M-Gargantua/FSAE-Dash-Warning-Panel/Dash_Warning_Panel.kicad_pcb

## KiCad design Dash_Warning_Panel.kicad_pcb (2019-04-27)

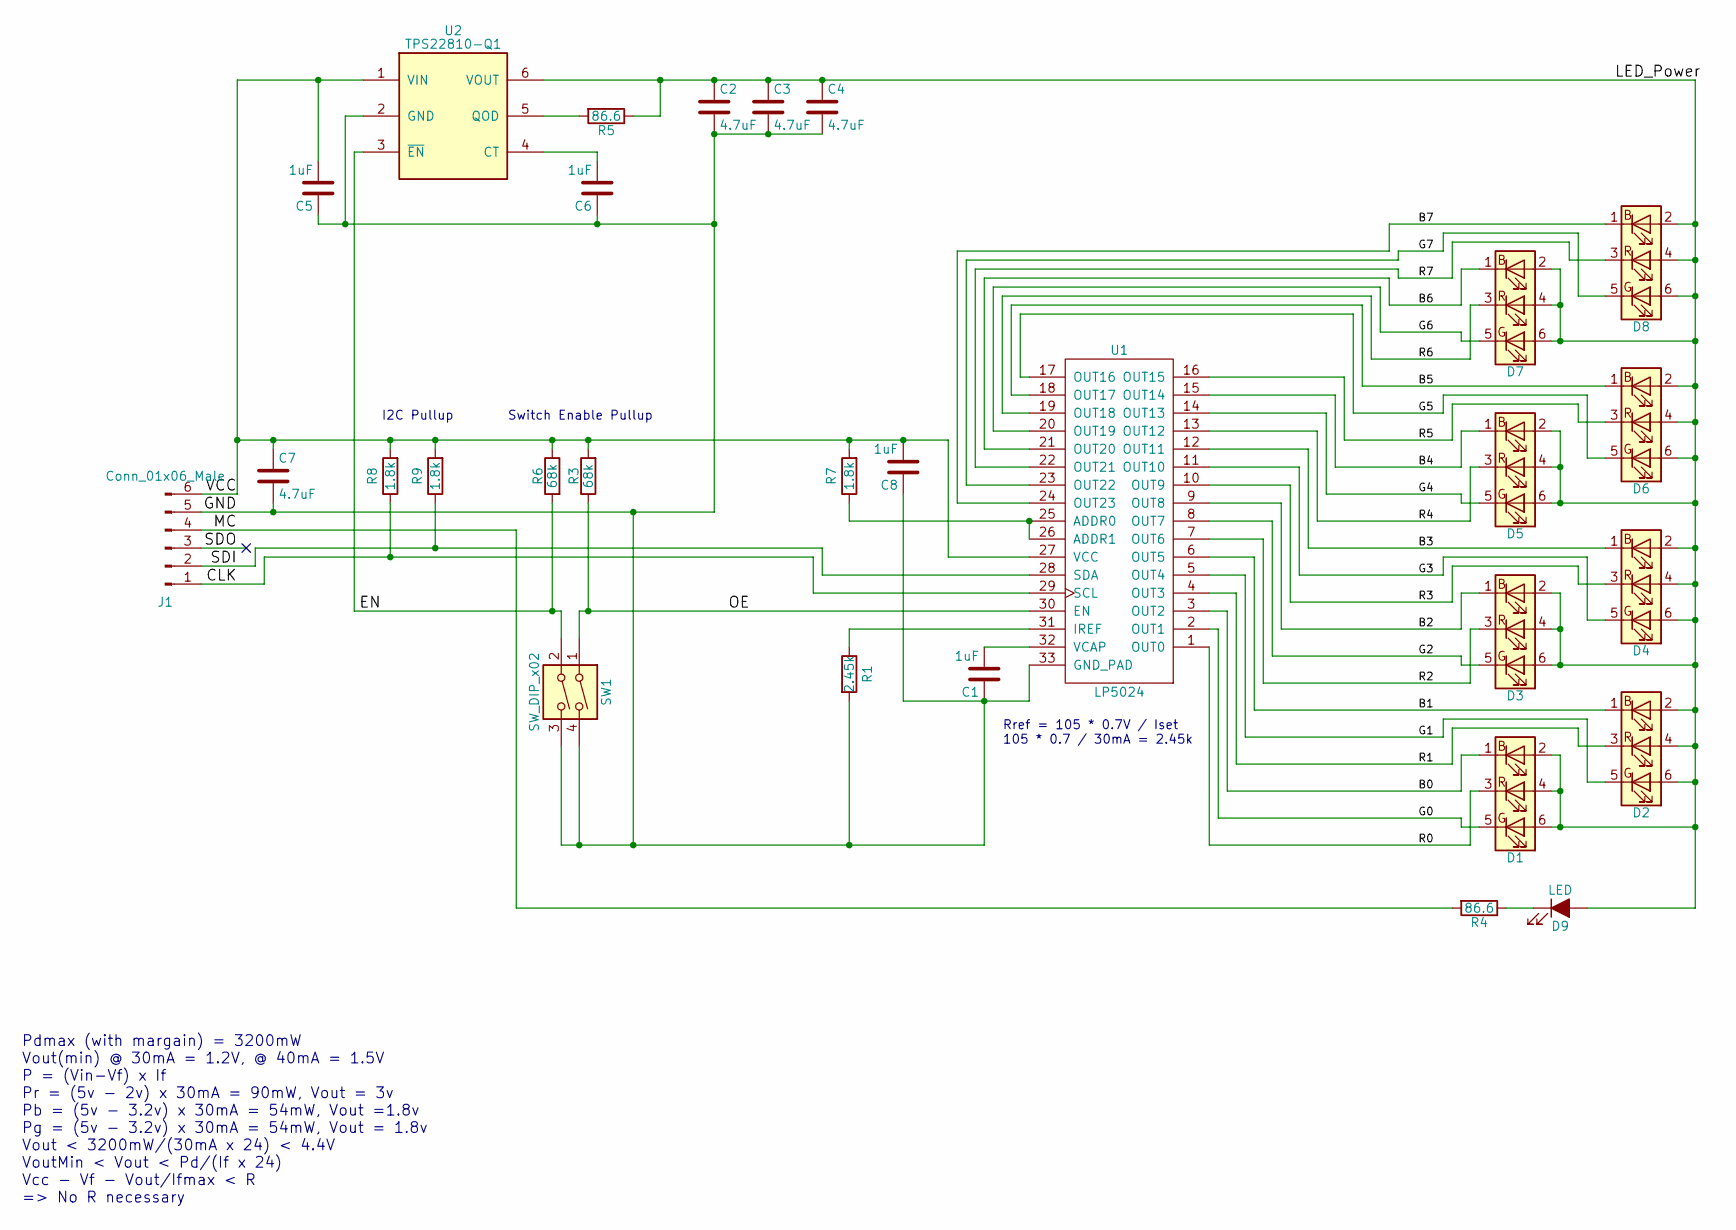
[picture p1: schematic Dash_Warning_Panel.sch]

Parts:
C1, C5, C6, C8: 1uF; C_0805
C2, C3, C4, C7: 4.7uF; C_1206
D1, D2, D3, D4, D5, D6, D7, D8: LED_RGB_Wurth; LED_RGB_3528
D9: LED; LED_0805
J1: Conn_01x06_Male; TE_84953-6_1x06_P1.0mm_Horizontal
R1: 2.45k; R_1206
R3, R6: 68k; R_1206
R4, R5: 86.6; R_0805
R7, R8, R9: 1.8k; R_0805
SW1: SW_DIP_x02; 2.54mm_DIP_Switch_2_Position
U1: LP5024; QFN-32-1EP_5x5mm_Pitch0.5mm
U2: TPS22810-Q1; SOT-23-6

Connections:
/B0: D1.1 (BK), U1.3 (OUT2)
/B1: D2.1 (BK), U1.6 (OUT5)
/B2: D3.1 (BK), U1.9 (OUT8)
/B3: D4.1 (BK), U1.12 (OUT11)
/B4: D5.1 (BK), U1.15 (OUT14)
/B5: D6.1 (BK), U1.18 (OUT17)
/B6: D7.1 (BK), U1.21 (OUT20)
/B7: D8.1 (BK), U1.24 (OUT23)
/CLK: J1.1, R8.1, U1.29 (SCL)
/EN: R6.2, SW1.2, U2.3 (~EN)
/G0: D1.5 (RK), U1.2 (OUT1)
/G1: D2.5 (RK), U1.5 (OUT4)
/G2: D3.5 (RK), U1.8 (OUT7)
/G3: D4.5 (RK), U1.11 (OUT10)
/G4: D5.5 (RK), U1.14 (OUT13)
/G5: D6.5 (RK), U1.17 (OUT16)
/G6: D7.5 (RK), U1.20 (OUT19)
/G7: D8.5 (RK), U1.23 (OUT22)
/GND: C1.1, C2.2, C3.2, C4.2, C5.1, C6.1, C7.2, C8.1, J1.5, R1.2, SW1.3, SW1.4, U1.33 (GND_PAD), U2.2 (GND)
/LED_Power: C2.1, C3.1, C4.1, D1.2 (BA), D1.4 (GA), D1.6 (RA), D2.2 (BA), D2.4 (GA), D2.6 (RA), D3.2 (BA), D3.4 (GA), D3.6 (RA), D4.2 (BA), D4.4 (GA), D4.6 (RA), D5.2 (BA), D5.4 (GA), D5.6 (RA), D6.2 (BA), D6.4 (GA), D6.6 (RA), D7.2 (BA), D7.4 (GA), D7.6 (RA), D8.2 (BA), D8.4 (GA), D8.6 (RA), D9.2 (A), R5.1, U2.6 (VOUT)
/MC: J1.4, R4.2
/OE: R3.1, SW1.1, U1.30 (EN)
/R0: D1.3 (GK), U1.1 (OUT0)
/R1: D2.3 (GK), U1.4 (OUT3)
/R2: D3.3 (GK), U1.7 (OUT6)
/R3: D4.3 (GK), U1.10 (OUT9)
/R4: D5.3 (GK), U1.13 (OUT12)
/R5: D6.3 (GK), U1.16 (OUT15)
/R6: D7.3 (GK), U1.19 (OUT18)
/R7: D8.3 (GK), U1.22 (OUT21)
/SDI: J1.2, R9.1, U1.28 (SDA)
/SDO: J1.3
/VCC: C5.2, C7.1, C8.2, J1.6, R3.2, R6.1, R7.2, R8.2, R9.2, U1.27 (VCC), U2.1 (VIN)
unnamed: C1.2, U1.32 (VCAP)
unnamed: C6.2, U2.4 (CT)
unnamed: D9.1 (K), R4.1
unnamed: R1.1, U1.31 (IREF)
unnamed: R5.2, U2.5 (QOD)
unnamed: R7.1, U1.25 (ADDR0), U1.26 (ADDR1)

Notes on the sheet:
Pdmax (with margain) = 3200mW Vout(min) @ 30mA = 1.2V, @ 40mA = 1.5V P = (Vin-Vf) x If Pr = (5v - 2v) x 30mA = 90mW, Vout = 3v Pb = (5v - 3.2v) x 30mA = 54mW, Vout =1.8v Pg = (5v - 3.2v) x 30mA = 54mW, Vout = 1.8v Vout < 3200mW/(30mA x 24) < 4.4V VoutMin < Vout < Pd/(If x 24) Vcc - Vf - Vout/Ifmax 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
Rref = 105 * 0.7V / Iset 105 * 0.7 / 30mA = 2.45k
I2C Pullup
Switch Enable Pullup

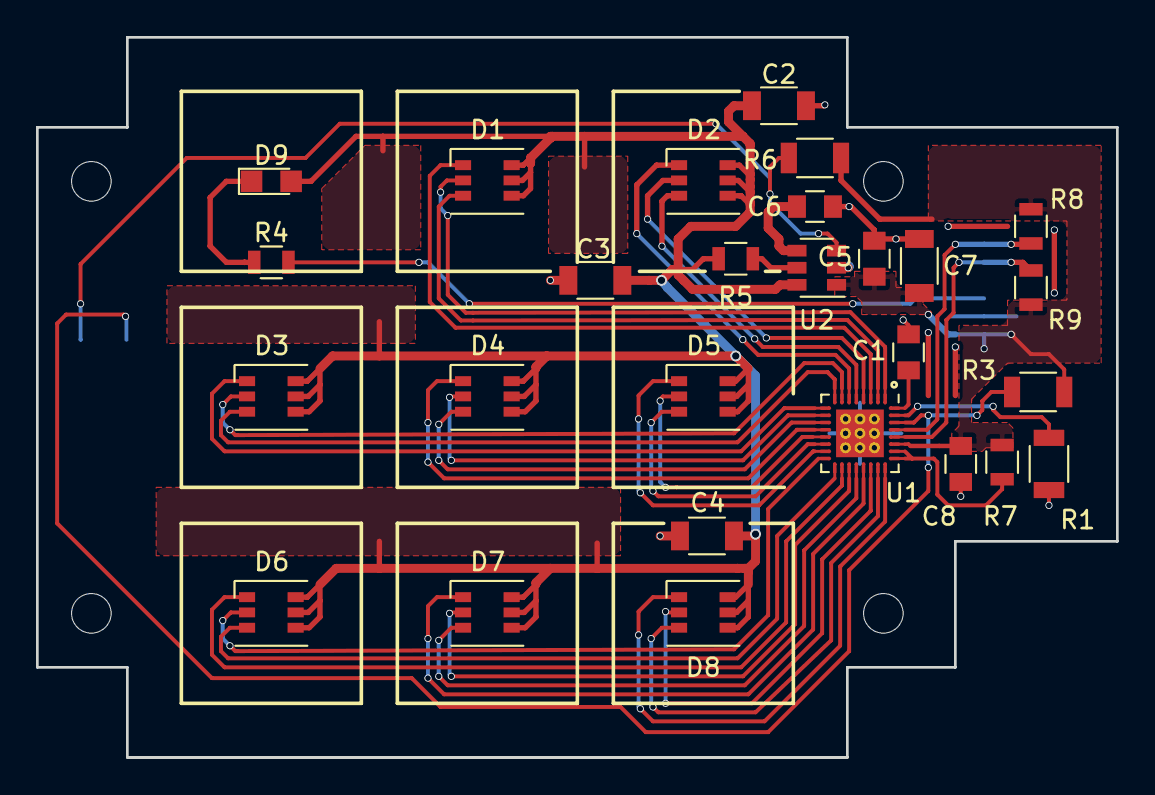
[picture p2: board Dash_Warning_Panel.kicad_pcb from above]

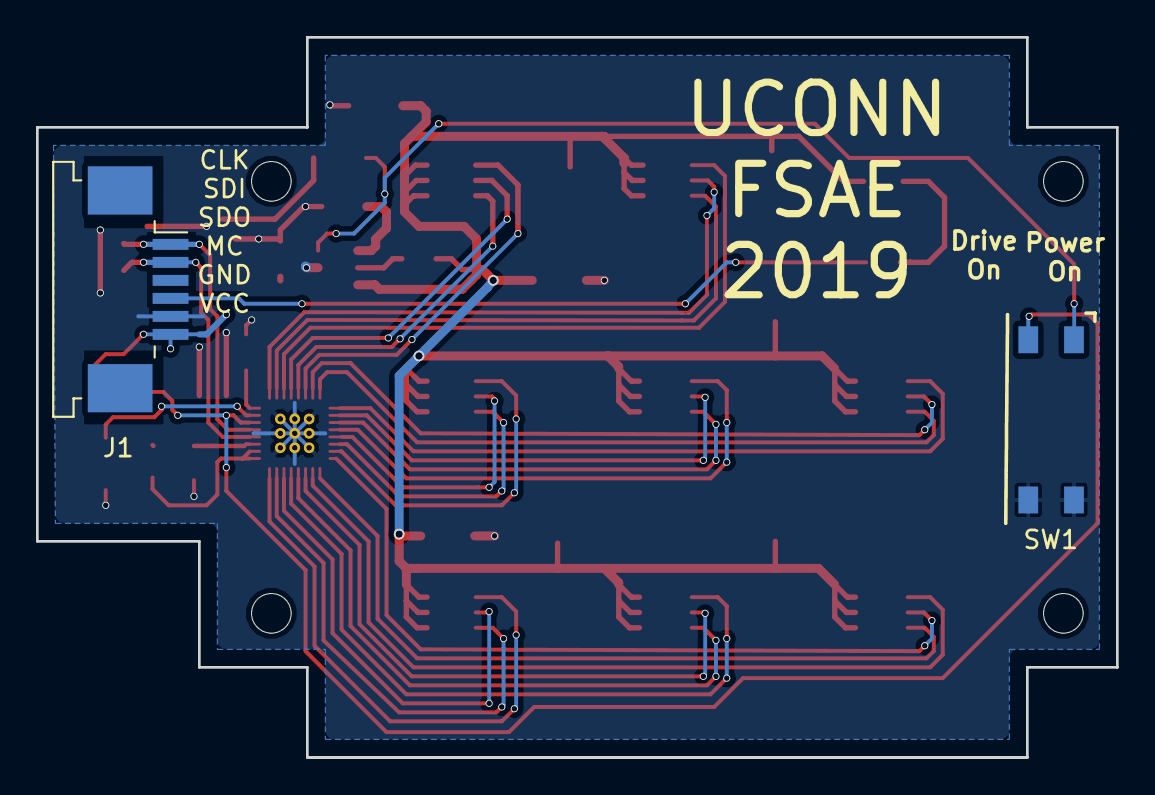
[picture p3: board Dash_Warning_Panel.kicad_pcb from below]

Board: 2 copper layers, 60.0 x 40.0 mm, 29 parts (2 on the bottom side), 38 nets.
