M-Gargantua/FSAE-Dash-Warning-Panel/(commit log)

2018-10-12 Initial Design
    Takes a 6pin FPC connector with +5V, GND, LED 1 Drain, SDO, SDI, and SCLK. Serial goes to a ROHM 24ch RGB LED driver board to control LED 2-9. Includes a power switch to limit inrush current to LED power rail and two dip switches to selectively enable/disable operability.
    [Dash_Warning_Panel.kicad_pcb, Dash_Warning_Panel.sch]
2018-10-12 Fixed Ground Pour and Silkscreen
2018-10-12 Fixed C6 footprint
    [Dash_Warning_Panel.csv, Dash_Warning_Panel.kicad_pcb, Dash_Warning_Panel.sch]
2018-10-18 Base Production
    Extended Board Outline, Fixed Solder Mask overlay, added ground via's for thermal pad under U1, added flood fill capacitors for VCC and LED Power in unoccupied boardspace.
    [Dash_Warning_Panel-B.Cu.gbl, Dash_Warning_Panel-B.Mask.gbs, Dash_Warning_Panel-B.SilkS.gbo, Dash_Warning_Panel-Cmts.User.gbr, Dash_Warning_Panel-Edge.Cuts.gm1, Dash_Warning_Panel-F.Cu.gtl, Dash_Warning_Panel-F.Mask.gts, Dash_Warning_Panel-F.SilkS.gto]
2019-03-20 Fabrication 2
    [Dash_Warning_Panel-B.Cu.gbl, Dash_Warning_Panel-B.Mask.gbs, Dash_Warning_Panel-B.Paste.gbp, Dash_Warning_Panel-B.SilkS.gbo, Dash_Warning_Panel-Edge.Cuts.gm1, Dash_Warning_Panel-F.Cu.gtl, Dash_Warning_Panel-F.Mask.gts, Dash_Warning_Panel-F.Paste.gtp]
2019-03-21 Fabrication 2
    Flipped side for switch
    [Dash_Warning_Panel.kicad_pcb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]
2019-03-28 Production 2
    [Dash_Warning_Panel-2019-03-28-11-09-20.sch]
2019-04-16 Fixed I2C
    Address is 01111000
    [Dash_Warning_Panel-B.Cu.gbl, Dash_Warning_Panel-B.Mask.gbs, Dash_Warning_Panel-B.Paste.gbp, Dash_Warning_Panel-B.SilkS.gbo, Dash_Warning_Panel-Edge.Cuts.gm1, Dash_Warning_Panel-F.Cu.gtl, Dash_Warning_Panel-F.Mask.gts, Dash_Warning_Panel-F.Paste.gtp]
2019-04-27 Routing with LP5024
    Ready for Fabrication Review
    [Dash_Warning_Panel-B.Cu.gbl, Dash_Warning_Panel-B.Mask.gbs, Dash_Warning_Panel-B.Paste.gbp, Dash_Warning_Panel-B.SilkS.gbo, Dash_Warning_Panel-Edge.Cuts.gm1, Dash_Warning_Panel-F.Cu.gtl, Dash_Warning_Panel-F.Mask.gts, Dash_Warning_Panel-F.Paste.gtp]
